Mat198/RoboTCC/README.md

# RoboTCC
Robô diferencial que montei para o meu TCC.
