Mat198/RoboTCC/(list of files, cad)

Other CAD files:
Inventor_2021/Ball Caster.ipt
Inventor_2021/Bateria.ipt
Inventor_2021/Disco encoder magnético.ipt
Inventor_2021/Eixo da roda.ipt
Inventor_2021/Encoder lateral.ipt
Inventor_2021/Espaçador Nylon Ø6x15mm.ipt
Inventor_2021/Espaçador do eixo.ipt
Inventor_2021/Mancal com rolamento.iam
Inventor_2021/Mancal inferior dos motores.ipt
Inventor_2021/Mancal inferior.ipt
Inventor_2021/Mancal superior.ipt
Inventor_2021/Montagem Motor.iam
Inventor_2021/Montagem do robô completo.iam
Inventor_2021/MontagemPneuRoda.iam
Inventor_2021/Motor HP 100-1 Pololu eixo estendido.ipt
Inventor_2021/Nova Engrenagem/Gears_22.iam
Inventor_2021/Nova Engrenagem/Gears_22/Design Accelerator/OldVersions/Spur Gear11.0001.ipt
Inventor_2021/Nova Engrenagem/Gears_22/Design Accelerator/OldVersions/Spur Gear21.0001.ipt
Inventor_2021/Nova Engrenagem/Gears_22/Design Accelerator/OldVersions/Spur Gears1.0001.iam
Inventor_2021/Nova Engrenagem/Gears_22/Design Accelerator/Spur Gear11.ipt
Inventor_2021/Nova Engrenagem/Gears_22/Design Accelerator/Spur Gear21.ipt
Inventor_2021/Nova Engrenagem/Gears_22/Design Accelerator/Spur Gears1.iam
Inventor_2021/Nova Engrenagem/Gears_22_edit.iam
Inventor_2021/Nova Engrenagem/OldVersions/Gears_22.0001.iam
Inventor_2021/Nova Engrenagem/OldVersions/Gears_22_edit.0001.iam
Inventor_2021/Parafuso - M3x0,5 x 20.ipt
Inventor_2021/Parafuso - M3x0,5 x 30.ipt
Inventor_2021/Parafuso Allen - M3 x 12.ipt
Inventor_2021/Piso dos motores.ipt
Inventor_2021/Piso e tampa dos motores.iam
Inventor_2021/Placa de Aço.ipt
Inventor_2021/Plaquinha.ipt
Inventor_2021/Porca - M3 x 0,5.ipt
Inventor_2021/Roda.ipt
Inventor_2021/Rolamento 6x3x2,5mm.ipt
Inventor_2021/Rolamento 6x3x2mm.ipt
Inventor_2021/Separador engrenagens.ipt
Inventor_2021/Suporte Ball Caster Max.ipt
Inventor_2021/Suporte lateral da bateria.ipt
Inventor_2021/espaçador sext. 10mm.ipt
Inventor_2021/espaçador sext. 20mm.ipt
Inventor_2021/pneu_com_piso.ipt
Inventor_2021/roda aluminio oring.ipt
