Mat198/RoboTCC/CubeIDE_TCC/Robo_TCC/Core/Src/main.c

/* USER CODE BEGIN Header */
/**
 ******************************************************************************
 * Arquivo           : main.c
 *
 * Descrição         : Código do microcontrolador ARM para os robôs VSSS da
 * 					Equipe Red Dragons UFSCar. Desenvolvido por Matheus
 * 					Sousa Soares em 2020.
 *
 * 					Para contato: matheussousasf@gmail.com ou
 * 								  matheussousa@df.ufscar.br
 * 								  (31) 975340460
 *
 ******************************************************************************
 ******************************************************************************
 *
 * Organizar código com comentários e com um mini interface no começo
 *
 *
 ******************************************************************************
 ******************************************************************************
 * Código desenvolvido na CUBE IDE 1.7.0
 *
 * Lista de funções desempenhadas:
 * Comunicação UART por interrupção com módulo Xbee
 * Leitura e interpretação da mensagem recebida
 * Geração de PWM para motores
 * Leitura dos Encoders
 * Controle da velocidade dos motores com PWM gerado
 * Modo de ajuste do controlador
 *
 * ****************************************************************************
 * Como utilizar:
 *
 * Editar nas partes com "USER CODE" o resto do código é gerado automaticamente
 * pela parte de configuração do microcontrolador na IDE (arquivo .ioc).
 *
 * Organize e comente as suas funções e códigos adequadamente para facilitar
 * para os membros futuros da equipe. Utilize o Git para atualizar o código.
 *
 * Modo de Controle:
 * 	Ativar a variável "medir_vel" = 1
 *
 * 	Para medir a velocidade sem controlador:
 * 		Ativar a variável "desl_controlador" = 1
 * 		Sertar PWM do teste na variável "PWM_test"
 * 		O robô então vai se mover com a tensão nos motores correspondente ao PWM setado
 * 		Depois de medir a velocidade por uma quantidade de pontos igual a "vetor_dados"
 * 		O robô vai parar e enviar os dados pelo módulo de rádio.
 *
 * 	Para medir a velocidade com o controlador:
 * 		Desativar a variável "desl_controlador" = 0
 * 		Setar a velocidade alvo de cada controlador nas variáveis "w_targetM1" e "w_targetM12"
 * 			Essa velocidade está em rad/s
 * 		Depois de medir a velocidade por uma quantidade de pontos igual a "vetor_dados"
 * 		O robô vai parar e enviar os dados pelo módulo de rádio.
 *
 * Modo de jogo:
 * 	Desativar a variável "medir_vel" = 0
 * 	O robô vai aguradar uma menságem para definir o setpoint do controlar
 *
 *		OBS: O tempo de loop do controlador e da medição dos dados foi definido em 10ms por
 *			conta da resolução dos encoders.
 *
 * ***************************************************************************
 * Partes do código
 * USER CODE Header: Comentários de introdução
 * USER CODE Includes: Bibliotecas do usuário
 * USER CODE PV: Vazio
 * USER CODE 0: Declaração de variáveis
 * USER CODE 1: Variáveis da equação de controle e
 * USER CODE SysInit: Vazio
 * USER CODE 2: Inicialização do sistema
 * USER CODE WHILE: Loop de programa
 * USER CODE 3: Vazio
 * USER CODE 4: Funções de interrupção e timers
 *
 * Preencher aqui conforme o código for atualizado, por favor.
 ******************************************************************************
 */
/* USER CODE END Header */
/* Includes ------------------------------------------------------------------*/
#include "main.h"

/* USER CODE BEGIN Includes */
#include "math.h"
/* USER CODE END Includes */

TIM_HandleTypeDef htim2;
TIM_HandleTypeDef htim3;
TIM_HandleTypeDef htim4;

UART_HandleTypeDef huart2;

void SystemClock_Config(void);
static void MX_GPIO_Init(void);
static void MX_TIM2_Init(void);
static void MX_TIM3_Init(void);
static void MX_TIM4_Init(void);
static void MX_USART2_UART_Init(void);
/* USER CODE BEGIN PFP */

static void controlador(void);
static void medir(void);
static void testPulsos(void);
static void returnMsg(void);
static void speedGet(void);

/* USER CODE END PFP */

/* USER CODE BEGIN 0 */

//Variáveis gerais
static int true = 1;
static int false = 0;
uint16_t delay = 500;

//Variáveis do modo de controle
int vetor_dados = 150;
int PWM_testM1 = 0;
int PWM_testM2 = 0;

double w_targetM1 = 0.0;
double w_targetM2 = 0.0;

int cont_vel = 0;
double velocidadesM1[150]= {};
double velocidadesM2[150]= {};
uint8_t buffer_vel[7] = {'0','0',',','0','0','0','\n'};



int stopMedir = 1;

int retorno = 0;
int testEncoder = 0;
int medir_vel = 0;
int controlar = 1;
int runMode = 1;

//Variáveis de comunicação serial
uint8_t size_msg = 10;
uint8_t tx_buffer[] = {'L','i','g','a','d','o',' ',' ',' ','\n'}; // Msg inicial enviada pelo robô
uint8_t configFlag[] = {'R','0','E','0','M','0','C','1','G','1','\n'};
uint8_t rx_buffer[10]; //Buffer que recebe as mensagens
uint8_t pulsos_motors[19];


// Variáveis de controle dos motores
uint16_t duty_cycle = 0;
int speedM1 = 0;
int speedM2 = 0;
unsigned int pwmM1 = 0;
unsigned int pwmM2 = 0;
int sentidoM1 = 0;
int sentidoM2 = 0;
int const cont_loop = 200;

double w_rodaM1[2] = {};
double w_rodaM2[2] = {};

double acaoM1[2] = {0,0};
double acaoM2[2] = {0,0};
double erroM1[3] = {0,0,0};
double erroM2[3] = {0,0,0};

int pulse_cnt = 3200; // Contagem de pulsos do clock. É a resolução do PWM
int cont_controle = 0;
int contTempo = 0;
int npulsos = 12;
int cppM1[2] ={0,0};
int cppM2[2] = {0,0};
int flag_controle = 0;
int flag_velocidade = 0;

// Valores do controlador
double const K1 = 18; //0.12*3200/8.4; // 18
double const Td1 = 2e-3; // 4e-2;
double const Ti1 = 1e-2; // 8e-4;
double const K2 = 18;
double const Td2 = 2e-3;
double const Ti2 = 1e-2;

double const Tloop = 2.0/(cont_loop);

// Variáveis do controlador
double M1A1 = (1 + (Tloop/Ti1) + (Td1/Tloop));
double M1A2 = (-1 - 2*Td1/Tloop);
double M1A3 = Td1/Tloop;

double M2A1 = (1 + (Tloop/Ti2) + (Td2/Tloop));
double M2A2 = (-1 - 2*Td2/Tloop);
double M2A3 = Td2/Tloop;

double testVel[] = {12.345,67.890,12.345,67.890,12.345,67.890,12.345,67.890,12.345,67.890};

/* USER CODE END 0 */

/**
 * @brief  The application entry point.
 * @retval int
 */
int main(void)
{
	/* USER CODE BEGIN 1 */

	/*if (medir_vel == false){
		w_targetM1 = 0.0;
		w_targetM2 = 0.0;
	}*/

	/* USER CODE END 1 */

	/* MCU Configuration--------------------------------------------------------*/

	/* Reset of all peripherals, Initializes the Flash interface and the Systick. */
	HAL_Init();

	/* Configure the system clock */
	SystemClock_Config();

	/* Initialize all configured peripherals */
	MX_GPIO_Init();
	MX_TIM2_Init();
	MX_TIM3_Init();
	MX_TIM4_Init();
	MX_USART2_UART_Init();
	/* USER CODE BEGIN 2 */

	HAL_UART_Transmit_IT(&huart2, tx_buffer, size_msg);
	HAL_UART_Transmit_IT(&huart2, configFlag, 11);// envia a msg inicial
	HAL_UART_Receive_IT(&huart2, rx_buffer, size_msg);// Faz com que o robô ligue o receptor de msg
	HAL_TIM_PWM_Start(&htim2, TIM_CHANNEL_2); // Inicia o Timer 2 do PWM
	HAL_TIM_PWM_Start(&htim2, TIM_CHANNEL_1);
	HAL_TIM_Base_Start_IT(&htim2); // Inicia o Timer 2 no modo de interrupção.
	HAL_TIM_Encoder_Start(&htim3, TIM_CHANNEL_ALL); // Inicia o encoder M1
	HAL_TIM_Encoder_Start(&htim4, TIM_CHANNEL_ALL); //Inicia o módulo de leitura do encoder M2
	HAL_GPIO_WritePin(Led_i_GPIO_Port, Led_i_Pin, SET);// Desliga o led da placa de desenvolvimento

	HAL_GPIO_WritePin(M2A_GPIO_Port, M2A_Pin, SET);
	HAL_GPIO_WritePin(M2B_GPIO_Port, M2B_Pin, RESET);
	HAL_GPIO_WritePin(M1A_GPIO_Port, M1A_Pin, SET);
	HAL_GPIO_WritePin(M1B_GPIO_Port, M1B_Pin, RESET);

	HAL_GPIO_WritePin(Hbridge_GPIO_Port,Hbridge_Pin,SET);

	for (int i = 0; i < vetor_dados; i++) {
		velocidadesM1[i] = 0.0;
		velocidadesM2[i] = 0.0;
	}

	/* USER CODE END 2 */

	/* Infinite loop */
	/* USER CODE BEGIN WHILE */

	while (1){

		if (testEncoder == true) testPulsos();
		if(flag_velocidade == true) speedGet();
		if(flag_controle == true){
			if(controlar == true) controlador();
		}

		if (medir_vel == true){

			if(stopMedir == true){
				stopMedir = false;
				__HAL_TIM_SET_COMPARE(&htim2, TIM_CHANNEL_1, 0);
				__HAL_TIM_SET_COMPARE(&htim2, TIM_CHANNEL_2, 0);
				for (int i = 0; i < vetor_dados; i++) {
					velocidadesM1[i] = 0.0;
					velocidadesM2[i] = 0.0;
				}
				HAL_TIM_Base_Stop_IT(&htim2);
				HAL_Delay(1000); // Delay para esperar zerar a velocidade dos motores
				HAL_TIM_Base_Start_IT(&htim2);

			}

			if (cont_vel >= vetor_dados){
				__HAL_TIM_SET_COMPARE(&htim2, TIM_CHANNEL_1, 0);
				__HAL_TIM_SET_COMPARE(&htim2, TIM_CHANNEL_2, 0);
				/*HAL_GPIO_WritePin(M2A_GPIO_Port, M2A_Pin, RESET);
				HAL_GPIO_WritePin(M2B_GPIO_Port, M2B_Pin, RESET);
				HAL_GPIO_WritePin(M1A_GPIO_Port, M1A_Pin, RESET);
				HAL_GPIO_WritePin(M1B_GPIO_Port, M1B_Pin, RESET);*/
				medir();
			}

		}

	}
	/* USER CODE END WHILE */

}

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
/* USER CODE BEGIN 4 */

// Função chaamada quando o buffer de recepção está CHEIO
void HAL_UART_RxCpltCallback(UART_HandleTypeDef *huart){

	HAL_GPIO_TogglePin(Led_i_GPIO_Port,Led_i_Pin);

	//####################################################
	if(rx_buffer[0] == 'G'){// Função que inicia o PWM
		HAL_TIM_PWM_Start(&htim2, TIM_CHANNEL_2);
	}

	// Buffers de configuração do funcionamento do robô
	if(rx_buffer[0] == '%'){// Função vira para a direita

		if(rx_buffer[1] == 'R'){// Função vira para a direita
			if (retorno == true){
				retorno = false;
				configFlag[1] = '0';
			}
			else {
				retorno = true;
				configFlag[1] = '1';
			}
		}

		if(rx_buffer[1] == 'E'){// Função vira para a direita
			if (testEncoder == true){
				testEncoder = false;
				configFlag[3] = '0';
			}
			else {
				testEncoder = true;
				configFlag[3] = '1';
			}
		}

		if(rx_buffer[1] == 'M'){// Função vira para a direita
			if (medir_vel == true){
				medir_vel = false;
				configFlag[5] = '0';
			}
			else {
				medir_vel = true;
				configFlag[5] = '1';
				stopMedir = true;
				HAL_GPIO_WritePin(M1A_GPIO_Port, M1A_Pin, SET);
				HAL_GPIO_WritePin(M1B_GPIO_Port, M1B_Pin, RESET);
				HAL_GPIO_WritePin(M2A_GPIO_Port, M2A_Pin, SET);
				HAL_GPIO_WritePin(M2B_GPIO_Port, M2B_Pin, RESET);
				PWM_testM1 = 1000*(rx_buffer[2]-'0') + 100*(rx_buffer[3]-'0') + 10*(rx_buffer[4]-'0') + (rx_buffer[5]-'0');
				PWM_testM2 = 1000*(rx_buffer[6]-'0') + 100*(rx_buffer[7]-'0') + 10*(rx_buffer[8]-'0') + (rx_buffer[9]-'0');
				//if (controlar == true){
					w_targetM1 = PWM_testM1/100.0;
					w_targetM2 = PWM_testM2/100.0;
				//}
			}
		}

		if(rx_buffer[1] == 'C'){// Função vira para a direita
			if (controlar == true){
				controlar = false;
				configFlag[7] = '0';
			}
			else{
				controlar = true;
				configFlag[7] = '1';
			}
		}

		if(rx_buffer[1] == 'G'){// Função vira para a direita
			if (runMode == true){
				runMode = false;
				controlar = false;
				configFlag[9] = '0';
				configFlag[7] = '0';
			}
			else{
				runMode = true;
				controlar = true;
				configFlag[9] = '1';
				configFlag[7] = '1';
			}
		}

		if(rx_buffer[2] == '%'){// Função vira para a direita
			HAL_UART_Transmit_IT(&huart2, configFlag, 11);
		}

	}

	else{
		//####################################################
		// Interpreta a msg e converte em velocidade
		speedM1 = 1000*(rx_buffer[1]-'0') + 100*(rx_buffer[2]-'0') + 10*(rx_buffer[3]-'0') + (rx_buffer[4]-'0');
		// Interpreta a msg e converte em velocidade
		speedM2 = 1000*(rx_buffer[6]-'0') + 100*(rx_buffer[7]-'0') + 10*(rx_buffer[8]-'0') + (rx_buffer[9]-'0');
	}

	if (speedM1 > 2200){
		speedM1 = 2200;
	}
	if(speedM2 > 2200){
		speedM2 = 2200;
	}

	// Define novo alvo para a velocidade

	//w_targetM1 = speedM1/100.0;
	//w_targetM2 = speedM2/100.0;

	//####################################################
	//Parte que lida com o motor 1
	if(rx_buffer[0] == 'F'){// Função vira para a direita

		HAL_GPIO_WritePin(M1A_GPIO_Port, M1A_Pin, SET);
		HAL_GPIO_WritePin(M1B_GPIO_Port, M1B_Pin, RESET);
		//HAL_GPIO_TogglePin(Led_g_GPIO_Port,Led_g_Pin);
	}
	if(rx_buffer[0] == 'T'){// Função vira para a esquerda

		HAL_GPIO_WritePin(M1A_GPIO_Port, M1A_Pin, RESET);
		HAL_GPIO_WritePin(M1B_GPIO_Port, M1B_Pin, SET);
		//HAL_GPIO_TogglePin(Led_y_GPIO_Port,Led_y_Pin);

	}
	if(rx_buffer[0] == 'S'){// Função que par aos motores
		//HAL_TIM_PWM_Stop(&htim2, TIM_CHANNEL_2);
		//HAL_GPIO_TogglePin(Led_r_GPIO_Port,Led_r_Pin);

		//HAL_GPIO_WritePin(M1A_GPIO_Port, M1A_Pin, RESET);
		//HAL_GPIO_WritePin(M1A_GPIO_Port, M1B_Pin, RESET);
		speedM2 = 0;
	}

	//####################################################
	//Parte que lida com o motor 2
	if(rx_buffer[5] == 'F'){// Função vira para a direita

		HAL_GPIO_WritePin(M2A_GPIO_Port, M2A_Pin, SET);
		HAL_GPIO_WritePin(M2B_GPIO_Port, M2B_Pin, RESET);
		//HAL_GPIO_TogglePin(Led_g_GPIO_Port,Led_g_Pin);
	}
	if(rx_buffer[5] == 'T'){// Função vira para a esquerda

		HAL_GPIO_WritePin(M2A_GPIO_Port, M2A_Pin, RESET);
		HAL_GPIO_WritePin(M2B_GPIO_Port, M2B_Pin, SET);
		//HAL_GPIO_TogglePin(Led_y_GPIO_Port,Led_y_Pin);

	}
	if(rx_buffer[5] == 'S'){// Função que par aos motores
		//HAL_TIM_PWM_Stop(&htim2, TIM_CHANNEL_2);
		//HAL_GPIO_TogglePin(Led_r_GPIO_Port,Led_r_Pin);
		HAL_GPIO_WritePin(M2A_GPIO_Port, M2A_Pin, RESET);
		HAL_GPIO_WritePin(M2A_GPIO_Port, M2B_Pin, RESET);
		speedM2 = 0;
	}

	//####################################################

	else{
		__NOP();// Adicionado para fins de Debug portanto não faz nada
	}

	//####################################################
	// Ajusta o valor do duty cycle do PWM atualizando a velocidade do robô
	if(medir_vel == false && runMode == false){
		__HAL_TIM_SET_COMPARE(&htim2, TIM_CHANNEL_1, speedM1);
		__HAL_TIM_SET_COMPARE(&htim2, TIM_CHANNEL_2, speedM2);
	}

	if(medir_vel == false && runMode == true){
		w_targetM1 = speedM1/100.0;
		w_targetM2 = speedM2/100.0;
	}

	if(retorno == 1) returnMsg();

	HAL_UART_Receive_IT(&huart2, rx_buffer, size_msg);// Liga a recepção para a próxima msg


	//HAL_GPIO_TogglePin(Led_r_GPIO_Port,Led_r_Pin);

}

// Função executada depois que a msg é totalmente enviada

void HAL_UART_TxCpltCallback(UART_HandleTypeDef *huart){
	__NOP();

}

void HAL_UART_ErrorCallback(UART_HandleTypeDef *huart){
	HAL_GPIO_TogglePin(Led_i_GPIO_Port, Led_i_Pin);
}

// Mede o tempo para inicio do loop de controle
void HAL_TIM_PeriodElapsedCallback(TIM_HandleTypeDef *htim){

	cont_controle++;
	if (cont_controle == cont_loop){
		//HAL_GPIO_TogglePin(Led_y_GPIO_Port,Led_y_Pin);
		cont_controle = 0;
		flag_controle = true;
		flag_velocidade	= true;
	}
}

// Medição da velocidade -> acontece simuntanea ao controlador
void speedGet(void){

	// Ajusta o valor do duty cycle do PWM atualizando a velocidade do robô
	flag_velocidade = false;

	if(controlar == true){
		if(stopMedir == false && medir_vel == true){
			__HAL_TIM_SET_COMPARE(&htim2, TIM_CHANNEL_1, pwmM1);
			__HAL_TIM_SET_COMPARE(&htim2, TIM_CHANNEL_2, pwmM2);
		}
		if(runMode == true){
			__HAL_TIM_SET_COMPARE(&htim2, TIM_CHANNEL_1, pwmM1);
			__HAL_TIM_SET_COMPARE(&htim2, TIM_CHANNEL_2, pwmM2);
		}
	}
	else{
		if(stopMedir == false && medir_vel == true){
			__HAL_TIM_SET_COMPARE(&htim2, TIM_CHANNEL_1, PWM_testM1);
			__HAL_TIM_SET_COMPARE(&htim2, TIM_CHANNEL_2, PWM_testM2);
		}
	}

	cppM1[0] = TIM3->CNT;
	cppM2[0] = TIM4->CNT;

	// Começa o update

	// Checagem do sentido de rotação das rodas e calculo da velocidade

	if (TIM3->CNT >= cppM1[1]){
		sentidoM1 = 1;
		w_rodaM1[0] = (2*M_PI*(TIM3->CNT-cppM1[1]))/(npulsos);
	}

	if (TIM3->CNT < cppM1[1]) {
		sentidoM1 = 0;
		w_rodaM1[0] = (2*M_PI*(cppM1[1]-TIM3->CNT))/(npulsos);
	}

	if (TIM4->CNT >= cppM2[1]){
		sentidoM2 = 1;
		w_rodaM2[0] = (2*M_PI*(TIM4->CNT-cppM2[1]))/(npulsos);
	}

	if (TIM4->CNT < cppM2[1]){
		sentidoM2 = 0;
		w_rodaM2[0] = (2*M_PI*(cppM2[1]-TIM4->CNT))/(npulsos);
	}

	if (medir_vel == true && cont_vel <= vetor_dados){
		velocidadesM1[cont_vel] = w_rodaM1[0];
		velocidadesM2[cont_vel] = w_rodaM2[0];
		cont_vel ++;
		contTempo ++;
		/*if (contTempo > 150) {
			contTempo = 0;
		}

		uint8_t time[] = {'T','i','m',':','i','a','d','o','!','\n'};
		HAL_UART_Transmit_IT(&huart2, init, 10);*/
	}
	// Filtro para o estouro do encoder
	if (w_rodaM1[0] > 35) w_rodaM1[0] = w_rodaM1[1];
	if (w_rodaM2[0] > 35) w_rodaM2[0] = w_rodaM2[1];


	// Fim do update

	w_rodaM1[1] = w_rodaM1[0];
	w_rodaM2[1] = w_rodaM2[0];

	cppM1[1] = cppM1[0];
	cppM2[1] = cppM2[0];

}

// Controlador
void controlador(void){
	//HAL_GPIO_TogglePin(Led_g_GPIO_Port,Led_g_Pin);
	flag_controle = false;

	acaoM1[0] += K1*(M1A1*erroM1[0] + M1A2*erroM1[1] + M1A3*erroM1[2]);
	acaoM2[0] += K2*(M2A1*erroM2[0] + M2A2*erroM2[1] + M2A3*erroM2[2]);

	pwmM1 = ceil(acaoM1[0]);
	pwmM2 = ceil(acaoM2[0]);


	if (pwmM1 > 2000)	pwmM1 = 2000;
	if (pwmM1 < 0) pwmM1 = 0;
	if (pwmM2 > 2000) pwmM2 = 2000;
	if (pwmM2 < 0) pwmM2 = 0;


	// Atualizando variáveis para o próximo loop de controle
	erroM1[2] = erroM1[1];
	erroM2[2] = erroM2[1];

	erroM1[1] = erroM1[0];
	erroM2[1] = erroM2[0];

	erroM1[0] = w_targetM1 - w_rodaM1[0];
	erroM2[0] = w_targetM2 - w_rodaM2[0];

	acaoM1[1] = acaoM1[0];
	acaoM2[1] = acaoM2[0];
}

// Função para medir curva de velocidade dos motores
void medir(void){

	uint8_t motor1[] = {'M','O','T','O','R','_','1',' ','\n','\n'};
	uint8_t motor2[] = {'\n','M','O','T','O','R','_','2',' ','\n','\n'};

	HAL_UART_Transmit_IT(&huart2, motor1, 10);

	int aux;
	int aux1;

	for(int j = 0; j< vetor_dados; j++ ){
		aux = 0;
		aux1 = floor(velocidadesM1[j]*1000);

		for(int i = 0; i<5; i++ ){
			aux = aux1/pow(10,4-i);
			aux1 = aux1- aux*pow(10,4-i);
			buffer_vel[i] = aux +'0';
		}
		for (int i = 0; i<3; i++ ) {
			buffer_vel[5-i] = buffer_vel[4-i];
		}
		buffer_vel[2] =',';
		buffer_vel[6] = '\n';
		HAL_UART_Transmit_IT(&huart2, buffer_vel, 7);
		HAL_Delay(10);
		w_targetM1 = 0;
		w_targetM2 = 0;
	}

	HAL_Delay(500);
	/*
	buffer_vel[0] = ']';
	for (int i = 1; i<7; i++ ) {
		buffer_vel[i] = '#';
	}
	HAL_UART_Transmit_IT(&huart2, buffer_vel, 7);
	HAL_Delay(500);
	*/

	HAL_UART_Transmit_IT(&huart2, motor2, 11);

	HAL_Delay(500);

	aux = 0;
	aux1 = 0;

	for(int j = 0; j< vetor_dados; j++ ){
		aux = 0;
		aux1 = floor(velocidadesM2[j]*1000);

		for(int i = 0; i<5; i++ ){
			aux = aux1/pow(10,4-i);
			aux1 = aux1- aux*pow(10,4-i);
			buffer_vel[i] = aux +'0';
		}
		for (int i = 0; i<3; i++ ) {
			buffer_vel[5-i] = buffer_vel[4-i];
		}
		buffer_vel[2] =',';
		buffer_vel[6] = '\n';
		HAL_UART_Transmit_IT(&huart2, buffer_vel, 7);
		HAL_Delay(10);
	}
	/*
	buffer_vel[0] = ']';
	for (int i = 1; i<7; i++ ) {
		buffer_vel[i] = '#';
	}
	HAL_UART_Transmit_IT(&huart2, buffer_vel, 7);
	*/
	medir_vel = false;
	configFlag[5] = '0';
	stopMedir = true;
	cont_vel = 0;
}

//enivia o valor dospulsos dos motores para debug
void testPulsos(void){
	//Send pulse cont:
	int M1 = TIM3->CNT;
	int M2 = TIM4->CNT;
	int aux = 0;
	int aux1 = M1;

	pulsos_motors[0] = 'M';
	pulsos_motors[1] = '1';
	pulsos_motors[2] = ':';
	pulsos_motors[8] = 'M';
	pulsos_motors[9] = '2';
	pulsos_motors[10] = ':';
	pulsos_motors[17] = '!';
	pulsos_motors[18] = '\n';

	for(int i = 0; i<5; i++ ){
		aux = aux1/pow(10,4-i);
		aux1 = aux1- aux*pow(10,4-i);
		pulsos_motors[i+3] = aux +'0';
	}

	aux = 0;
	aux1 = M2;

	for(int i = 0; i<5; i++ ){
		aux = aux1/pow(10,4-i);
		aux1 = aux1- aux*pow(10,4-i);
		pulsos_motors[i+11] = aux +'0';
	}

	HAL_UART_Transmit_IT(&huart2, pulsos_motors, 19);
	HAL_Delay(500);

	HAL_GPIO_TogglePin(Led_i_GPIO_Port,Led_i_Pin);
}

void returnMsg(void){
	for(int i = 0; i < size_msg; i++ ){ // Clona e envia a msg recebida
		tx_buffer[i] = rx_buffer[i];
	}
	HAL_UART_Transmit_IT(&huart2, tx_buffer, 10);
}
/* USER CODE END 4 */
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
