Mat198/RoboTCC/CubeIDE_TCC/Robo_TCC/Core/Inc/main.h

#define Led_i_Pin GPIO_PIN_13
#define Led_i_GPIO_Port GPIOC
#define M2A_Pin GPIO_PIN_12
#define M2A_GPIO_Port GPIOB
#define M2B_Pin GPIO_PIN_13
#define M2B_GPIO_Port GPIOB
#define Hbridge_Pin GPIO_PIN_10
#define Hbridge_GPIO_Port GPIOA
#define M1A_Pin GPIO_PIN_4
#define M1A_GPIO_Port GPIOB
#define M1B_Pin GPIO_PIN_5
#define M1B_GPIO_Port GPIOB
