Mat198/RoboTCC/Interface e Controle/FT_estimativa.py

import control.matlab as ctrl
import matplotlib.pyplot as plt
import numpy as np

# 8,15 V
# 2,73V

M1_2_79 = [00.000,01.047,03.141,04.188,04.712,05.759,06.283,06.283,06.283,06.806,06.806,06.806,06.806,06.806,06.806,07.330,06.806,06.806,06.806,07.330,06.806,06.806,07.330,06.806,06.806,07.330,06.806,06.806,07.330,06.806,06.806,07.330,06.806,06.806,07.330,06.806,06.806,07.330,06.806,06.806,06.806,07.330,06.806,06.806,06.806,07.330,06.806,06.806,06.806,07.330,06.806,06.806,07.330,06.806,06.806,06.806,07.330,06.806,06.806,06.806,07.330,06.806,06.806,06.806,06.806,06.806,06.806,06.806,06.806,06.806,06.806,06.806,06.806,06.806,06.806,07.330,06.806,06.806,06.806,06.806,06.806,07.330,06.806,06.806,06.806,06.806,07.330,06.806,06.806,06.806,06.806,07.330,06.806,06.806,06.806,06.806,06.806,07.330,06.806,06.806,06.806,06.806,07.330,06.806,06.806,06.806,06.806,06.806,06.806,07.330,06.806,06.806,06.806,06.806,06.806,06.806,06.806,06.806,06.806,06.806,06.806,06.806,06.806,06.806,07.330,06.806,06.806,06.806,06.806,07.330,06.806,06.806,06.806,06.806,07.330,06.806,06.806,06.806,06.806,07.330,06.806,06.806,06.806,06.806,06.806,06.806,07.330,06.806,06.806,06.806]######

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
K = 2.55
p1 = 10
p2 = 100
Ts = ctrl.tf([K*p1*p2], [ 1,p1+p2,p1*p2])
print("\n Função de transferência da velocidade em rad/s: ")
print(Ts)

respMA_2_79, time = ctrl.step(2.73*Ts, 1.5)
respMA_4_00, time = ctrl.step(4.0*Ts, 1.5)
respMA_5_59, time = ctrl.step(5.5*Ts, 1.5)

plt.plot(time, respMA_2_79, label='Estimado 2,73 V')
plt.plot(time, respMA_4_00, label='Estimado 4,00 V')
plt.plot(time, respMA_5_59, label='Estimado 5,50 V')
plt.xlabel("Tempos [s]")
plt.ylabel("Velocidade [rad/s]")
plt.legend(["Velocidade Medida para 2,73V","Velocidade Medida para 4,0V","Velocidade Medida para 5,50V","Velocidade estimada para 2,73V","Velocidade estimada para 4,0V","Velocidade estimada para 5,50V"])
plt.show()
