Mat198/RoboTCC/(commit log)

2022-04-18 Primeira adição de arquivos
    [Ball Caster.ipt, Bateria.ipt, Disco encoder magnético.ipt, Eixo da roda.ipt, Encoder lateral.ipt, Espaçador Nylon Ø6x15mm.ipt, Espaçador do eixo.ipt, Gears_22.0001.iam]
2022-04-18 Pasta para organizar arquivos de CAD
2022-04-18 Organização completa dos arquivos
    [Ball Caster.ipt, Bateria.ipt, Disco encoder magnético.ipt, Dump.txt, Eixo da roda.ipt, Encoder lateral.ipt, Espaçador Nylon Ø6x15mm.ipt, Espaçador do eixo.ipt]
