Mat198/RoboTCC/(notices)

Notices in the files:
CubeIDE_TCC/Robo_TCC/Core/Inc/main.h:
Copyright (c) 2022 STMicroelectronics.
All rights reserved.
This software is licensed under terms that can be found in the LICENSE file
